forgevolt/Transmitter/README.md

# Transmitter

A general-purpose ESP32 remote control for small robots. It is not tied to any one machine: the
link carries a fixed set of controls, and the robot at the other end decides what they mean and
what the screen shows. A [hexapod](https://github.com/forgevolt/Hexapod) is the first thing it
was built to drive; adding another robot is a change to that robot's firmware, not to this one.

It comes in two variants, with one or two joysticks. Which one is running is a menu setting
stored on the device, and is announced to the robot when the link comes up.

| One joystick | Two joysticks |
|---|---|
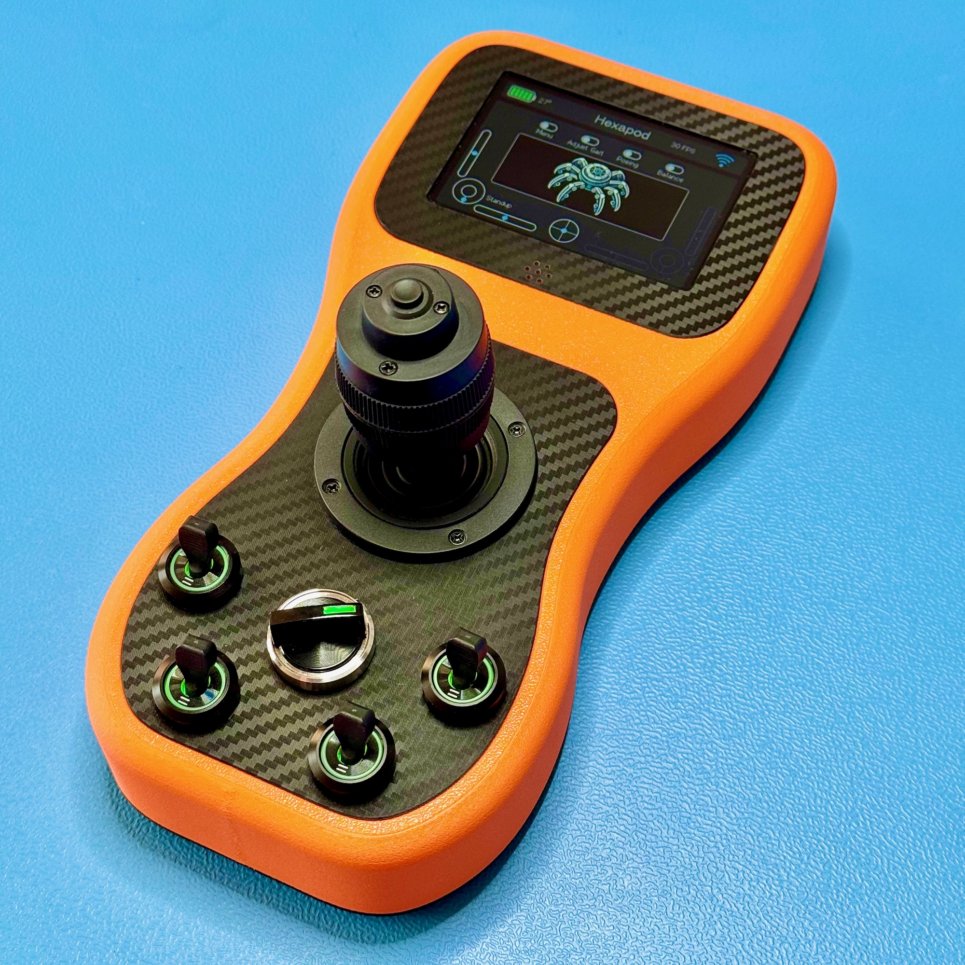
[picture p1: docs/transmitter-1joy.jpg]
Transmitter, one-joystick variant
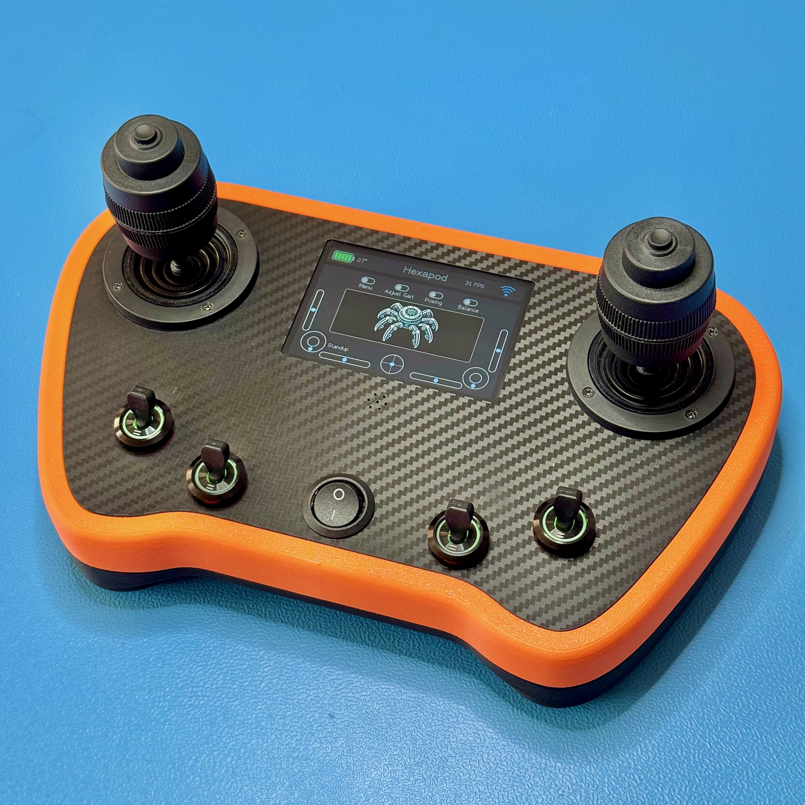
[picture p2: docs/transmitter-2joy.jpg]
Transmitter, two-joystick variant
|  |  |

## What it does

**Sends controls 20 times a second** — two 3-axis joysticks at ±1000 per axis, their two
buttons, four switches, and the transmitter's own tilt on two axes from the IMU. 

**Takes its screen contents from the robot.** The robot sends back a name, a device id (the 
transmitter presents an icon based on that information), a caption for each switch and button, 
and up to four label/value pairs. So a hexapod can label a switch `Gait` and display 
`height=` `13.4` without this firmware knowing anything about hexapods.

**Pairs by itself.** The robot broadcasts, the transmitter answers, and from then on each end
accepts frames only from the other. One peer at a time, dropped after a second of silence and
re-paired without user action. Both ends check a protocol version on every frame, so a robot
flashed from a different revision of the wire format reports a clear mismatch instead of
misreading values.

**Shows** battery charge, the paired robot's name and icon, live joystick positions, switch
states with their labels, IMU tilt, temperature, and an optional frame counter.

**Offers a menu** for joystick calibration (center and end stops per axis, stored in flash), IMU
calibration, one- or two-joystick selection, sound volume, frame-rate display, and a full reset.

**Makes noise** through an I2S amplifier — a click on every switch, a beep on button presses, a
sound at start-up.

## Hardware
- ESP32-WROOM-32E with 8 MB flash and no PSRAM (board package esp32 3.3.12)
- 480x320 TFT Display (ST7796 3.5)
- MPU6050 IMU  

## Repository layout

| | |
|---|---|
| [`software/`](software) | The Arduino sketch and its TFT_eSPI configuration |
| [`hardware/`](hardware) | PCB: EasyEDA project, Gerbers, schematic, bill of materials |
| [`mechanics/`](mechanics) | Housing: Fusion source, STLs, print profiles |
| [`docs/`](docs) | Photographs, wiring notes, display-image sources |

## The other end of the link

`software/Transmitter/RCProtocol.h` **is the master copy of the wire format.** It describes what
this transmitter can send and what it can display, so its shape follows this hardware rather
than any one robot's needs - which is why it lives here and not in the robot.

Every robot driven by this transmitter carries a copy of that file, because Arduino cannot
include across sketch folders. **Edit it here, then copy the result to each robot.**
`cAppProtocolVersion` is the guard: both ends check it on every frame, so a copy that has
fallen behind shows up as a logged mismatch at pairing rather than as silently misread data.

The robot announces itself with an `EDeviceType`, which is how the transmitter picks the icon
to show for it:

| Robot | `EDeviceType` |
|---|---|
| [Hexapod](https://github.com/forgevolt/Hexapod) | `eHexapod` |
| *(reserved for a balancing cube, not published)* | `eBalancingCube` |

A robot without its own image in `ReceiverStatus.cpp` is shown with a generic icon.

## Getting Started
1. Install the required libraries (see **Dependencies** below).
2. Open `software/Transmitter/Transmitter.ino` in the Arduino IDE.
3. Select the board and settings below.
4. Upload.

### Board settings

Board package **esp32 by Espressif, 3.3.12**. Select **ESP32 Dev Module** and change these
settings; everything else stays at its default:

| Setting | Value | Note |
| --- | --- | --- |
| Flash Size | **8MB (64Mb)** | the default is 4MB |
| PSRAM | **Disabled** | the module has none, and the firmware does not use any |
| Partition Scheme | **Custom** | only sets the upload size check; `partitions.csv` defines the layout, see below |

For `arduino-cli`, the same settings are the FQBN
`esp32:esp32:esp32:FlashSize=8M,PartitionScheme=custom`.

The partition scheme `software/Transmitter/partitions.csv` sits in the
sketch folder, and the ESP32 core uses it: a 6 MB application partition plus a 1.9 MB LittleFS 
partition. Nothing in the firmware writes to that filesystem today — calibration and settings 
live in NVS — so there is nothing to upload to it, but the space is reserved.

`partitions.csv` replaces whatever the Partition Scheme menu selects, so "Custom" is not strictly
needed. The menu only sets the size limit of the upload check: if "Custom" is not offered, choose
*Huge APP (3MB No OTA/1MB SPIFFS)*; the app is about 1.25 MB. With "Custom" the check allows the
whole 16 MB address space, so it does not guard the 6 MB application partition - a known limit,
far from the app's size.

The display needs no setting up: `software/Transmitter/build_opt.h` configures TFT_eSPI as part of
the build. See [software/Config/TFT_eSPI](software/Config/TFT_eSPI/README.md) if you would rather
configure the library the conventional way, or if you are not using the ESP32 Arduino core.

## Dependencies

Versions are the ones this project is built and tested against.

**Bundled with the ESP32 board package** - nothing to install: `WiFi`, `Networking`, `Wire`,
`SPI`, `Preferences`, and the ESP-IDF `driver/i2s_std.h` audio API that SoundEngine sits on.

**From the Arduino Library Manager** - all of them, including the four written for this project:

| Library | Version | Note |
|---|---|---|
| Streaming | 6.3.0 | |
| TFT_eSPI | 2.5.43 | by Bodmer - configured by `build_opt.h`, see above |
| Bounce2 | 2.71 | |
| MPU6050_light | 1.2.1 | by rfetick - several MPU6050 libraries exist, this is the one used here |
| Adafruit MAX1704X | 1.0.3 | |
| Adafruit BusIO | 1.17.4 | dependency of MAX1704X |
| [ESPNowUtilities](https://github.com/forgevolt/ESPNowUtilities) | 1.0.1 | the ESP-NOW transport `RCProtocol.h` is built on |
| [JoystickUtilities](https://github.com/forgevolt/JoystickUtilities) | 1.0.0 | reading, calibrating and storing the joysticks |
| [SoundEngine](https://github.com/forgevolt/SoundEngine) | 1.1.1 | `SoundEngine.h` and the `sounds/` clips |
| [VectorUtilities](https://github.com/forgevolt/VectorUtilities) | 1.0.0 | `mapf()`, `deg2rad` and the disk mapping of the IMU display |

## Compiler warnings

`software/Transmitter/build_opt.h` switches on more warnings than the core does:

```
-Wall
-Wextra
-Wdouble-promotion
-Wsign-compare
```

`-Wdouble-promotion` matters on the ESP32, which has no hardware double: it catches float maths
that silently turns into slow double maths. `-Wsign-compare` has to be listed by name: the core's
`cpp_flags` passes `-Wno-sign-compare`, and a specific `-Wno-` beats a later umbrella flag such as
`-Wall`. Arduino expands `build_opt.h` after `cpp_flags`, which is why overriding it there works.
The same file carries the TFT_eSPI configuration as `-D` flags; it is a compiler response file,
so it may hold flags only, no comments.

The firmware builds without a warning from its own sources. The flags apply to the core and the
libraries as well, so a clean build still lists about 70 warnings from those (core 3.3.12, the
MPU6050_light, TFT_eSPI and Adafruit MAX1704X libraries).

The IDE setting *Compiler warnings: None* (File → Preferences) passes `-w`, which hides every
warning, including the ones `build_opt.h` asks for. Use *Default* or higher. The IDE's output
panel also drops the start of a long log, so for a full warning check compile with the
`arduino-cli` that ships with the IDE and keep the log in a file outside the repository
(macOS paths):

```bash
CLI="/Applications/Arduino IDE.app/Contents/Resources/app/lib/backend/resources/arduino-cli"
cd software
"$CLI" compile --clean --warnings all \
  --fqbn "esp32:esp32:esp32:FlashSize=8M,PartitionScheme=custom" \
  Transmitter 2>&1 | tee ~/transmitter-build.log
```

`--warnings all` matters: without it `arduino-cli` uses `none`, which passes `-w` just like the
IDE setting. The flags themselves come from `build_opt.h`.

## How it runs

Four FreeRTOS tasks matter here. Everything the operator sees and sends runs in `loop()`:

| Task | Priority | Core | Rate | Does |
| --- | --- | --- | --- | --- |
| `loopTask` | 1 | 1 | screen 30 fps, send 20 Hz | `loop()`: input snapshot, UI step and draw, and the control frames - each job on its own schedule |
| `processEvents` | 1 | 1 | every 2 ms | debounces the two joystick buttons and the four switches (`InputController`) |
| `fillBuffer` | 1 | 1 | - | mixes and queues the next audio chunk (owned by SoundEngine) |
| Wi-Fi task | 23 | 0 | - | the ESP-NOW receive callback: pairing requests and the robot's telemetry |

The joysticks are read from `loop()` only. The button and switch state is shared with
`processEvents` under a mutex, and the received telemetry with the Wi-Fi task under another.

## License
This project is licensed under the MIT License – see the [LICENSE](LICENSE) file for details.
