forgevolt/Transmitter/docs/images/Hexapod.png

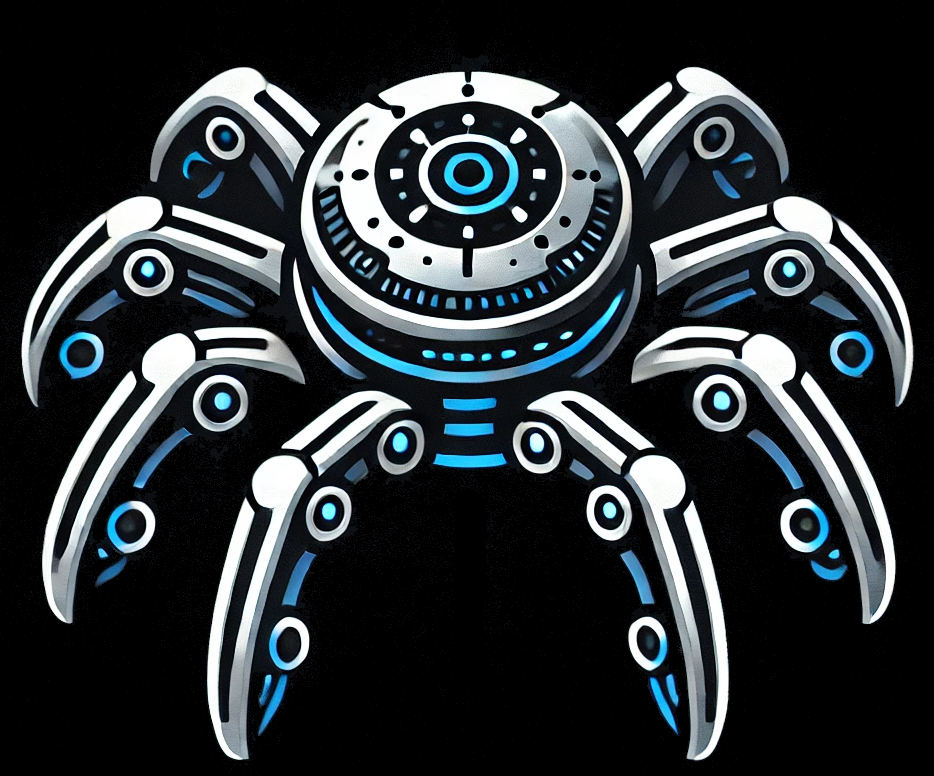
docs/images/Hexapod.png
