forgevolt/Transmitter/docs/images/UnknowReceiver.png

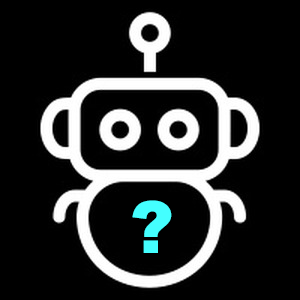
docs/images/UnknowReceiver.png
