forgevolt/Transmitter/hardware/bom.csv

No. | Quantity | Comment | Designator | Footprint | Value | Manufacturer Part | Manufacturer | Supplier Part | Supplier
1 | 1 | KLJ-01504T-08R05W | BUZ500 | BUZ-SMD_4P-L15.0-W15.0-BL |  | KLJ-01504T-08R05W | KELIKING(凯丽金) | C18186316 | LCSC
2 | 9 | 100nF | C200,C201,C204,C301,C302,C405,C501,C601,C602 | C0402_IPC | 100nF | CL05B104KO5NNNC | SAMSUNG(三星) | C1525 | LCSC
3 | 4 | 4.7uF | C202,C203,C406,C407 | C0805 | 4.7uF | GRM21BR71A475KE51L | muRata(村田) | C415536 | LCSC
4 | 1 | 22uF | C300 | C0805 | 22uF | CL21A226MAQNNNE | SAMSUNG(三星) | C45783 | LCSC
5 | 2 | 1uF | C303,C400 | C0603 | 1uF | CL10B105KP8NNNC | SAMSUNG(三星) | C95843 | LCSC
6 | 5 | 10uF | C401,C402,C403,C404,C500 | C0805 | 10uF | GCM21BR71A106KE22L | muRata(村田) | C126586 | LCSC
7 | 2 | 220pF | C502,C503 | C0402_IPC | 220pF | 0402B221K500NT | FH(风华) | C1530 | LCSC
8 | 1 | 10nF | C600 | C0402_IPC | 10nF | GRM155R71E103KA01D | muRata(村田) | C77013 | LCSC
9 | 1 | 2.2nF | C603 | C0402_IPC | 2.2nF | 0402B222K500NT | FH(风华) | C1531 | LCSC
10 | 1 | USBLC6-2SC6 | D200 | SOT-23-6_L2.9-W1.6-P0.95-LS2.8-BL |  | USBLC6-2SC6 | ST(意法半导体) | C7519 | LCSC
11 | 1 | Display | H700 | HDR-TH_9P-P2.54-V-F-1 |  | 2.54-1*9P母 | BOOMELE(博穆精密) | C39576 | LCSC
12 | 1 | SOLDERJUMPER | J300 | SOLDERJUMPER
13 | 2 | GZ1608D121TF SMT业务专用 | L500,L501 | L0603 |  | GZ1608D121TF SMT业务专用 |  | C18527 | LCSC
14 | 1 | +3V3 | LED400 | LED0402-RD_YELLOW
15 | 1 | Charge | LED401 | LED0805-RD_GREEN
16 | 4 | M3-MOUNT-HOLE | M700,M701,M702,M703 | M3-MOUNT-HOLE
17 | 1 | SMUN5211DW1T1G | Q300 | SOT-363_L2.0-W1.3-P0.65-LS2.1-BL |  | SMUN5211DW1T1G | onsemi(安森美) | C463894 | LCSC
18 | 1 | 22.1kΩ | R200 | R0402 | 22.1kΩ | 0402WGF2212TCE | UNI-ROYAL(厚声) | C43473 | LCSC
19 | 1 | 47.5kΩ | R201 | R0402 | 47.5kΩ | 0402WGF4752TCE | UNI-ROYAL(厚声) | C25896 | LCSC
20 | 1 | 1kΩ | R202 | R0402 | 1kΩ | 0402WGF1001TCE | UNI-ROYAL(厚声) | C11702 | LCSC
21 | 2 | 5.1kΩ | R203,R204 | R0402 | 5.1kΩ | 0402WGF5101TCE | UNI-ROYAL(厚声) | C25905 | LCSC
22 | 4 | 4.7kΩ | R300,R301,R403,R600 | R0402 | 4.7kΩ | 0402WGJ0472TCE | UNI-ROYAL(厚声) | C25940 | LCSC
23 | 4 | 10kΩ | R302,R400,R401,R404 | R0402 | 10kΩ | 0402WGF1002TCE | UNI-ROYAL(厚声) | C25744 | LCSC
24 | 1 | 2kΩ | R402 | R0402 | 2kΩ | 0402WGF2001TCE | UNI-ROYAL(厚声) | C4109 | LCSC
25 | 1 | 0Ω_DNP | R500 | R0402 | 0Ω | 0402WGJ0000TCE | UNI-ROYAL(厚声) | C21376 | LCSC
26 | 1 | 0Ω | R501 | R0402 | 0Ω | 0402WGJ0000TCE | UNI-ROYAL(厚声) | C21376 | LCSC
27 | 1 | 1MΩ | R502 | R0402 | 1MΩ | 0402WGF1004TCE | UNI-ROYAL(厚声) | C26083 | LCSC
28 | 1 | Reset | SW300 | SW-SMD_5P-L4.2-W2.8-P1.60-LS4.6-TR |  | KMR211GLFS | C&K | C221675 | LCSC
29 | 1 | USB | TP200 | TESTPOINT-SMD |  | KH-PG2012005-DZ | kinghelm(金航标) | C2842936 | LCSC
30 | 1 | VIN | TP400 | TESTPOINT-SMD |  | KH-PG2012005-DZ | kinghelm(金航标) | C2842936 | LCSC
31 | 1 | +3V3 | TP401 | TESTPOINT-SMD |  | KH-PG2012005-DZ | kinghelm(金航标) | C2842936 | LCSC
32 | 1 | VBAT | TP402 | TESTPOINT-SMD |  | KH-PG2012005-DZ | kinghelm(金航标) | C2842936 | LCSC
33 | 1 | CP2102N-A02-GQFN24R | U200 | QFN-24_L4.0-W4.0-P0.50-TL-EP2.6 |  | CP2102N-A02-GQFN24R | SKYWORKS/SILICON LABS(芯科) | C969151 | LCSC
34 | 1 | ESP32-WROOM-32E-N8 | U300 | WIFI-SMD_ESP32-WROOM-32E |  | ESP32-WROOM-32E-N8 | ESPRESSIF(乐鑫) | C701342 | LCSC
35 | 1 | AP3602AKTR-G1 | U400 | SOT-23-6_L2.9-W1.6-P0.95-LS2.8-BR |  | AP3602AKTR-G1 | DIODES(美台) | C460358 | LCSC
36 | 1 | LM66200DRLR | U401 | SOT-583-8_L2.1-W1.2-P0.50-LS1.6-BL |  | LM66200DRLR | TI(德州仪器) | C3235556 | LCSC
37 | 1 | LD39200PUR | U402 | DFN-6_L3.0-W3.0-P0.95-BL-EP-1 |  | LD39200PUR | ST(意法半导体) | C2969757 | LCSC
38 | 1 | MCP73831T-2ACI/MC | U403 | DFN-8_L3.0-W2.0-P0.50-BL-EP1.6 |  | MCP73831T-2ACI/MC | MICROCHIP(美国微芯) | C411870 | LCSC
39 | 1 | MAX17048G+T10 | U404 | DFN-8_L2.0-W2.0-P0.50-BL-EP |  | MAX17048G+T10 | ADI(亚德诺)/MAXIM(美信) | C2682616 | LCSC
40 | 1 | MAX98357AETE+T | U500 | TQFN-16_L3.0-W3.0-P0.50-BL-EP1.5 |  | MAX98357AETE+T | ADI(亚德诺)/MAXIM(美信) | C910544 | LCSC
41 | 1 | MPU-6050 | U600 | QFN-24_L4.0-W4.0-P0.50-BL-EP2.7 |  | MPU-6050 | TDK InvenSense(应美盛) | C24112 | LCSC
42 | 1 | Lipo | U700 | conn-th_2p-p2.00_bx-ph2.0-2pwz |  | BX-PH2.0-2PWZ | Bossie(博锡) | C18077753 | LCSC
43 | 1 | Joystick Left | U701 | CONN-TH_6P-P2.00_BX-PH2.0-6PWZ |  | BX-PH2.0-6PWZ | Bossie(博锡) | C18077757 | LCSC
44 | 1 | Joystick Right | U702 | conn-th_6p-p2.00_bx-ph2.0-6pwz |  | BX-PH2.0-6PWZ | Bossie(博锡) | C18077757 | LCSC
45 | 1 | On/Off | U703 | CONN-TH_4P-P2.00_BX-PH2.0-4PWZ |  | BX-PH2.0-4PWZ | Bossie(博锡) | C18077755 | LCSC
46 | 1 | Switch 1 | U704 | CONN-TH_3P-P2.00_BX-PH2.0-3PWZ |  | BX-PH2.0-3PWZ | Bossie(博锡) | C18077754 | LCSC
47 | 1 | Switch 3 | U705 | CONN-TH_3P-P2.00_BX-PH2.0-3PWZ |  | BX-PH2.0-3PWZ | Bossie(博锡) | C18077754 | LCSC
48 | 1 | Switch 2 | U706 | CONN-TH_3P-P2.00_BX-PH2.0-3PWZ |  | BX-PH2.0-3PWZ | Bossie(博锡) | C18077754 | LCSC
49 | 1 | Switch 4 | U707 | CONN-TH_3P-P2.00_BX-PH2.0-3PWZ |  | BX-PH2.0-3PWZ | Bossie(博锡) | C18077754 | LCSC
50 | 1 | USB4105-GF-A | USB200 | TYPE-C-SMD_SBC-160S1A-20-S412 |  | USB4105-GF-A | GCT | C3020560 | LCSC
