forgevolt/Transmitter/mechanics/print-profiles/2-Joystick-LightPipe.3mf

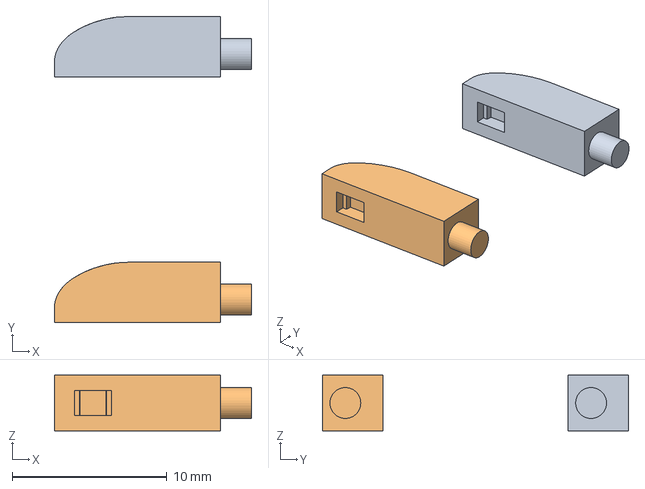
[picture p5: CAD file, 2026-08-06]
mechanics/print-profiles/2-Joystick-LightPipe.3mf
12.8 x 19.8 x 3.60 mm
Spot-2-Joysticks.stl x 2
