forgevolt/Transmitter/mechanics/stl/2-joysticks.stl

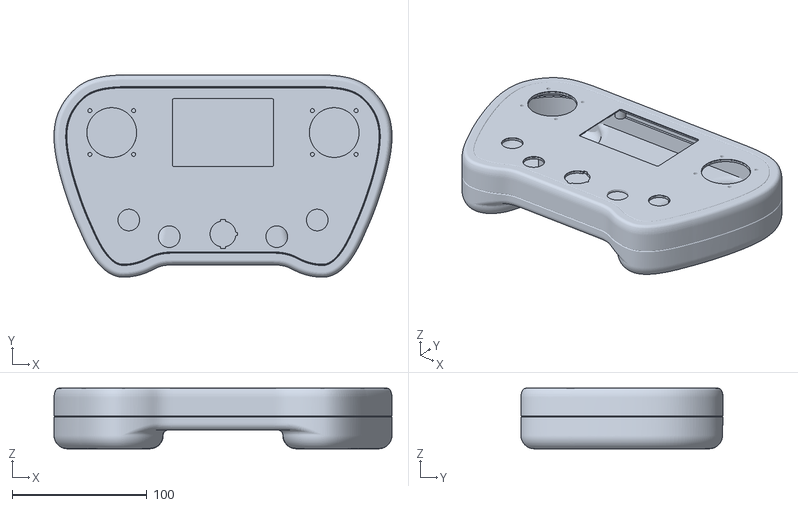
[picture p6: CAD file, 2026-08-06]
mechanics/stl/2-joysticks.stl
251.1 x 150.3 x 45.0
