forgevolt/Transmitter/mechanics/print-profiles/2-Joystick-Bottom-h2d-PETG-CF.3mf

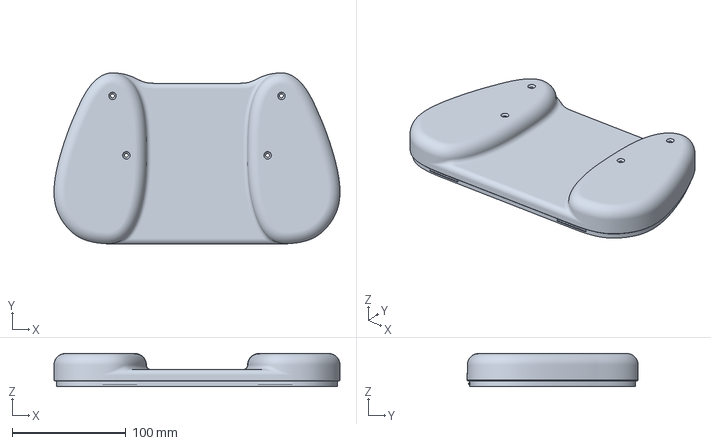
[picture p7: CAD file, 2026-08-06]
mechanics/print-profiles/2-Joystick-Bottom-h2d-PETG-CF.3mf
251.1 x 150.3 x 29.0 mm
