forgevolt/Transmitter/mechanics/stl/1-joystick.stl

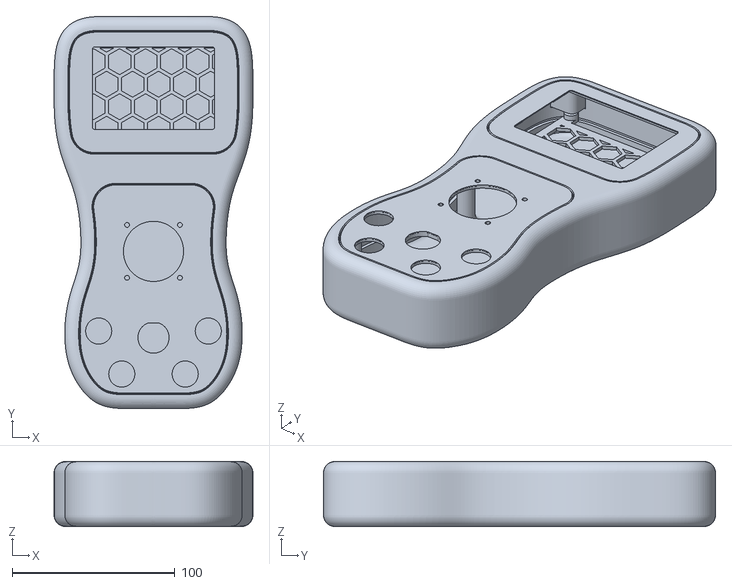
[picture p8: CAD file, 2026-08-06]
mechanics/stl/1-joystick.stl
122.3 x 241.1 x 40.0
