forgevolt/Transmitter/mechanics/print-profiles/1-Joystick-Top-h2d-ABS-GF.3mf

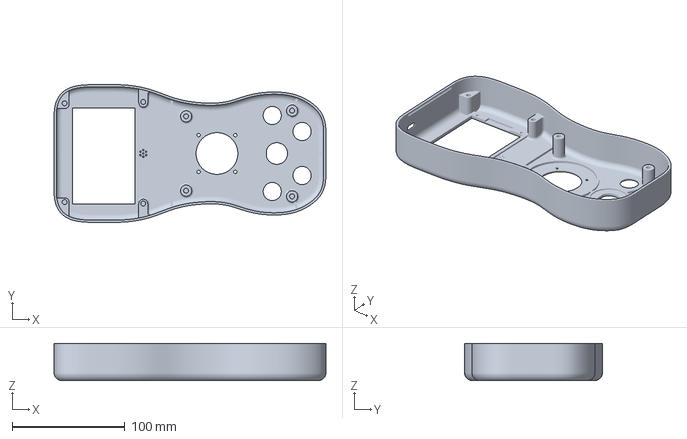
[picture p9: CAD file, 2026-08-06]
mechanics/print-profiles/1-Joystick-Top-h2d-ABS-GF.3mf
241.1 x 122.3 x 33.0 mm
