forgevolt/Transmitter/mechanics/print-profiles/2-Joystick-Top-h2d-ABS-GF.3mf

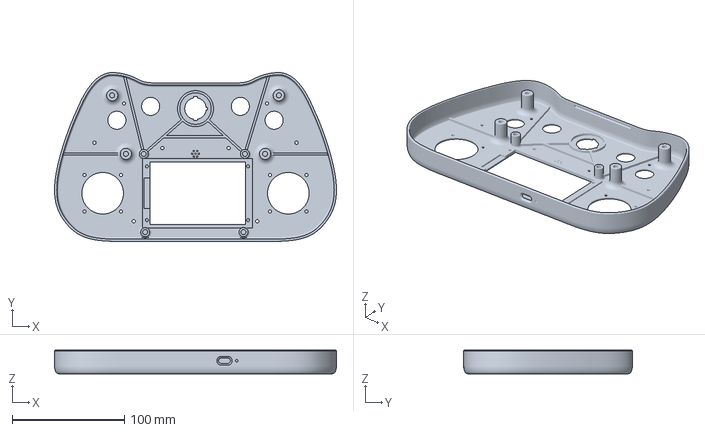
[picture p10: CAD file, 2026-08-06]
mechanics/print-profiles/2-Joystick-Top-h2d-ABS-GF.3mf
251.1 x 150.3 x 21.0 mm
