forgevolt/Transmitter/mechanics/print-profiles/1-Joystick-Bottom-h2d-PLA-GF.3mf

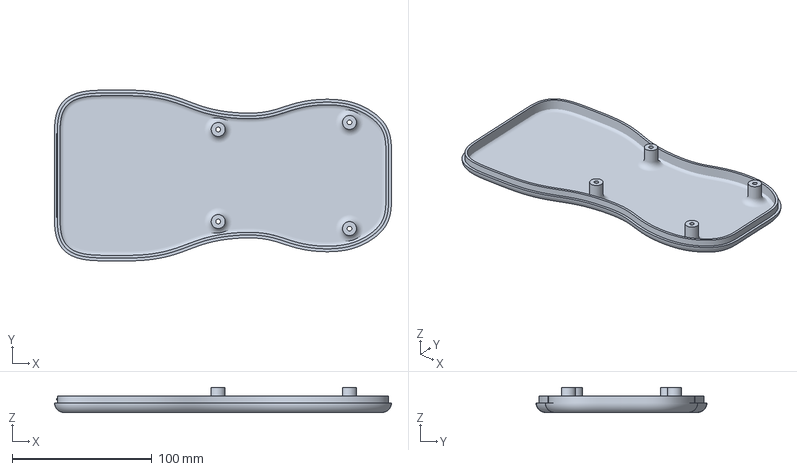
[picture p11: CAD file, 2026-08-06]
mechanics/print-profiles/1-Joystick-Bottom-h2d-PLA-GF.3mf
241.1 x 122.3 x 18.0 mm
