forgevolt/Transmitter/mechanics/print-profiles/1-Joystick-LightPipe.3mf

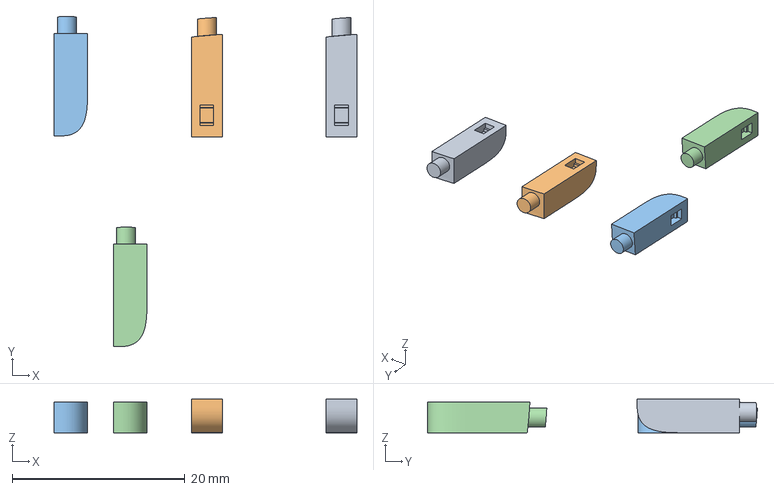
[picture p12: CAD file, 2026-08-06]
mechanics/print-profiles/1-Joystick-LightPipe.3mf
35.1 x 38.2 x 3.90 mm
1-Joystick.stl x 4
