forgevolt/Transmitter/mechanics/print-profiles/2-Joystick-CarbonPlatePrinting.3mf

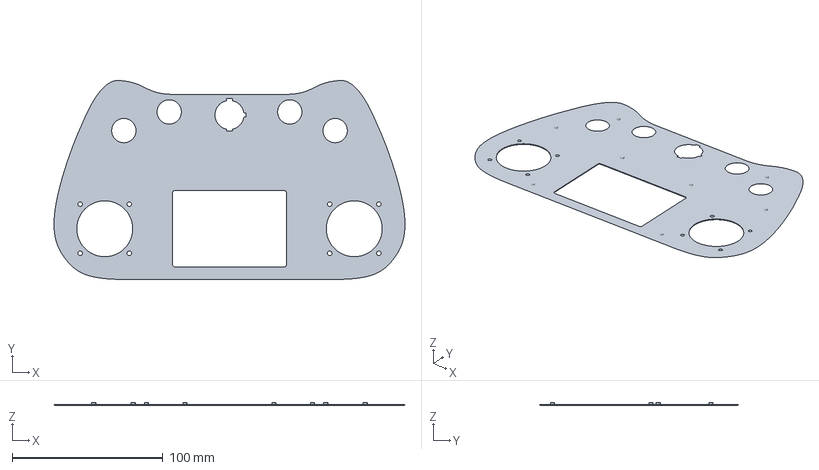
[picture p13: CAD file, 2026-08-06]
mechanics/print-profiles/2-Joystick-CarbonPlatePrinting.3mf
232.5 x 131.7 x 1.90 mm
