forgevolt/Transmitter/(list of files, cad)

Other CAD files:
mechanics/print-profiles/2-Joystick-Bottom-h2d-ABS-GF.3mf
mechanics/print-profiles/2-Joystick-Bottom-h2d-PLA-CF.3mf
mechanics/cad/Remote.f3z
