forgevolt/Transmitter/hardware/schematic.pdf

Drawn
VER

Create Date

PAGE | OF

Schematic

Update Date

SIZE

Page

2025-01-01

## 2025-01-01 Remote_R2

## Overview

# Hobbyist

## Christoph Streit

1 | A4

# Microcontroller

# Audio & IMU

Sheet: USB&Serial | Sheet: ESP32
2 | 3

# Sheet: Audio

5

I/O

# Sheet: Connectors / IO

7

# Power

# Sheet: Power

4

6

# Sheet: IMU

# USB to Serial USB

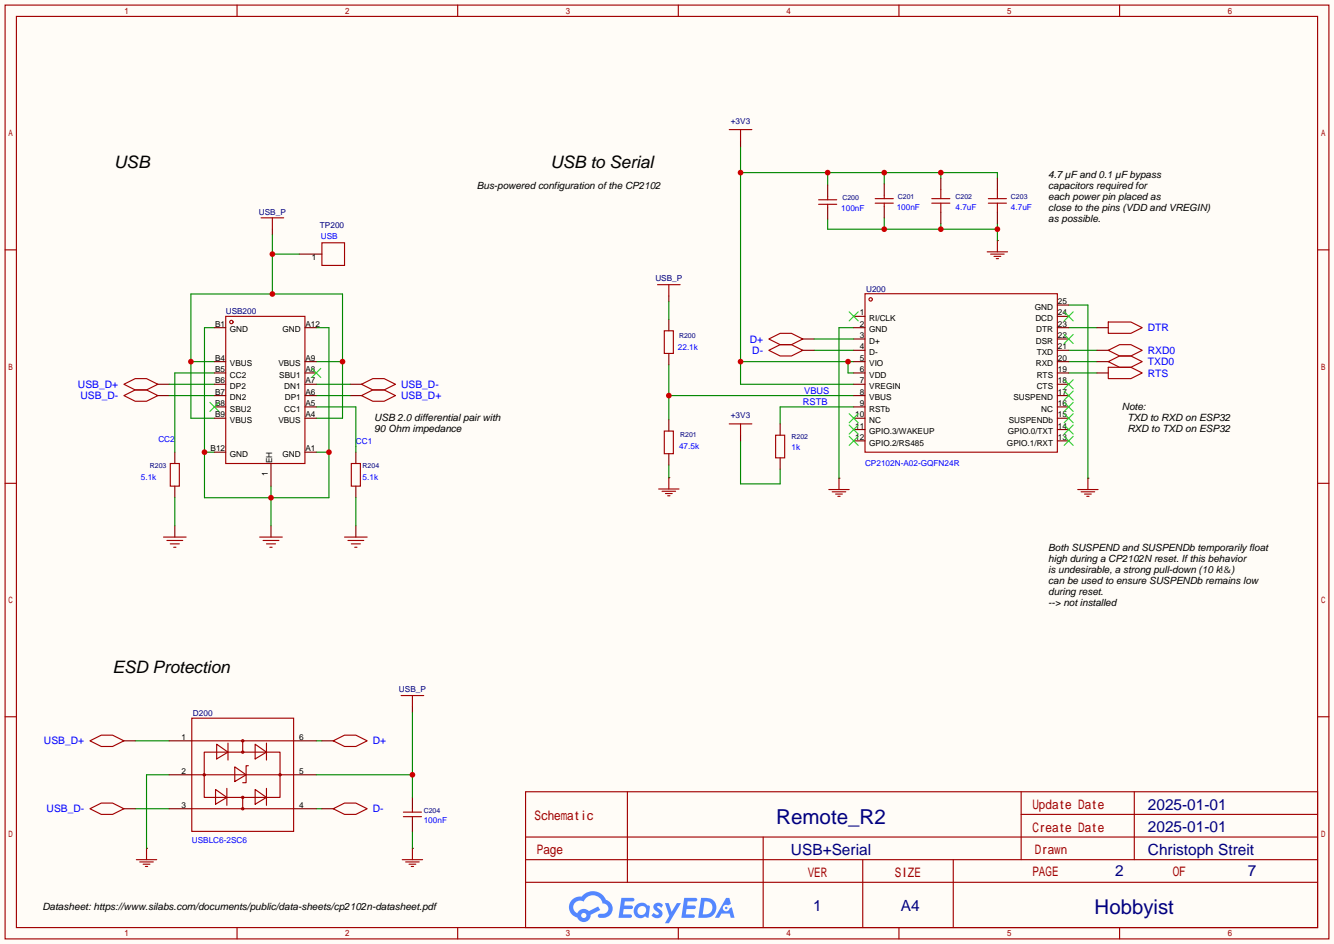
[picture p14: page 2]

4.7 µF and 0.1 µF bypass
capacitors required for
each power pin placed as
close to the pins (VDD and VREGIN)
as possible.

Bus-powered configuration of the CP2102

Note:
TXD to RXD on ESP32
RXD to TXD on ESP32

Both SUSPEND and SUSPENDb temporarily float
high during a CP2102N reset. If this behavior
is undesirable, a strong pull-down (10 k!&)
can be used to ensure SUSPENDb remains low
during reset.
--> not installed

Datasheet: https://www.silabs.com/documents/public/data-sheets/cp2102n-datasheet.pdf

# ESP32--WROOM-32E

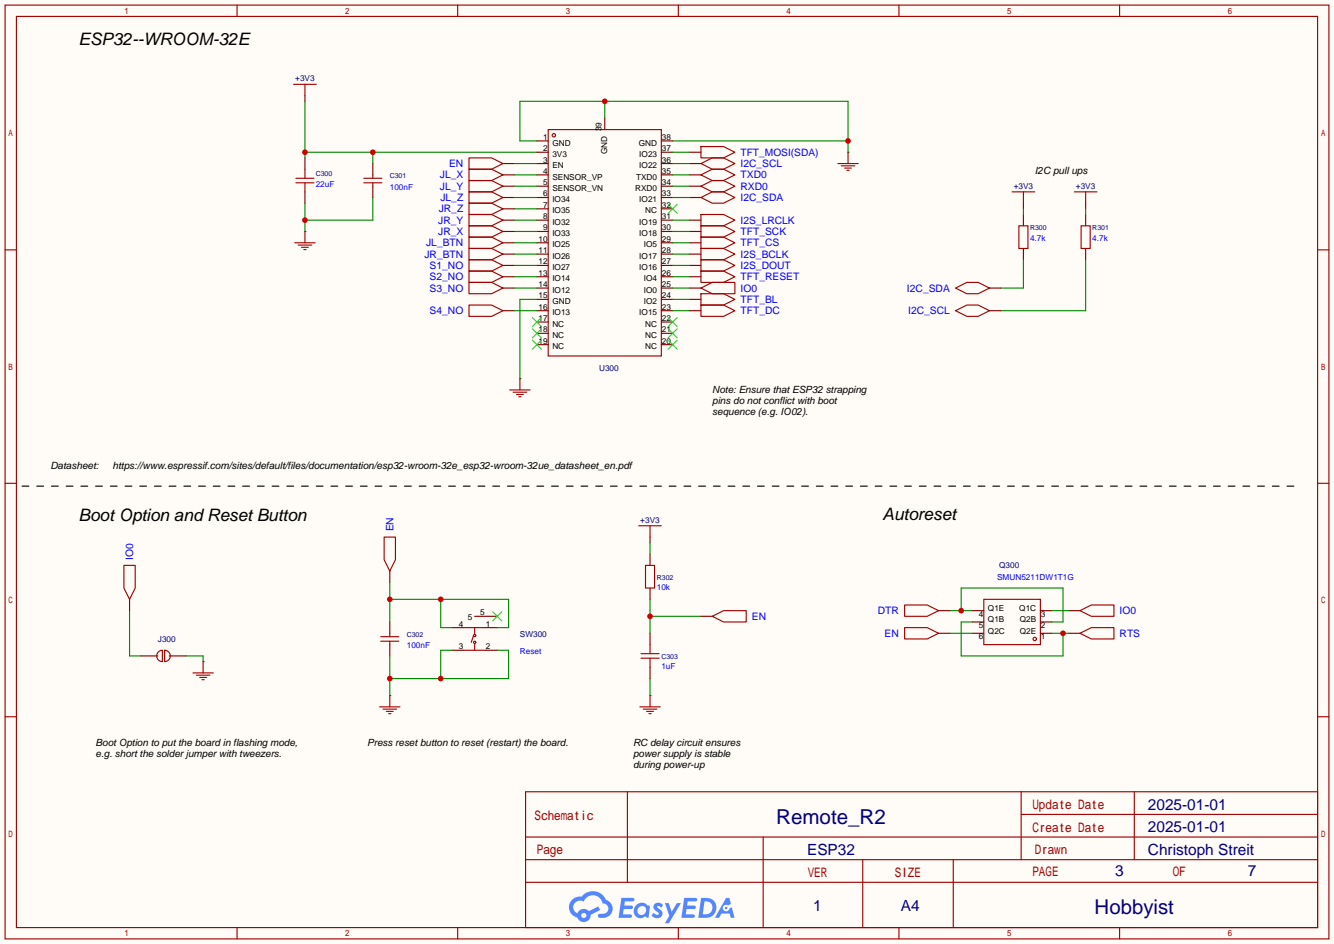
[picture p15: page 3]

Note: Ensure that ESP32 strapping
pins do not conflict with boot
sequence (e.g. IO02).

https://www.espressif.com/sites/default/files/documentation/esp32-wroom-32e_esp32-wroom-32ue_datasheet_en.pdf

Boot Option to put the board in flashing mode,
e.g. short the solder jumper with tweezers.

Press reset button to reset (restart) the board.

RC delay circuit ensures
power supply is stable
during power-up

# Automatic Switchover Charge Pump (+5V)

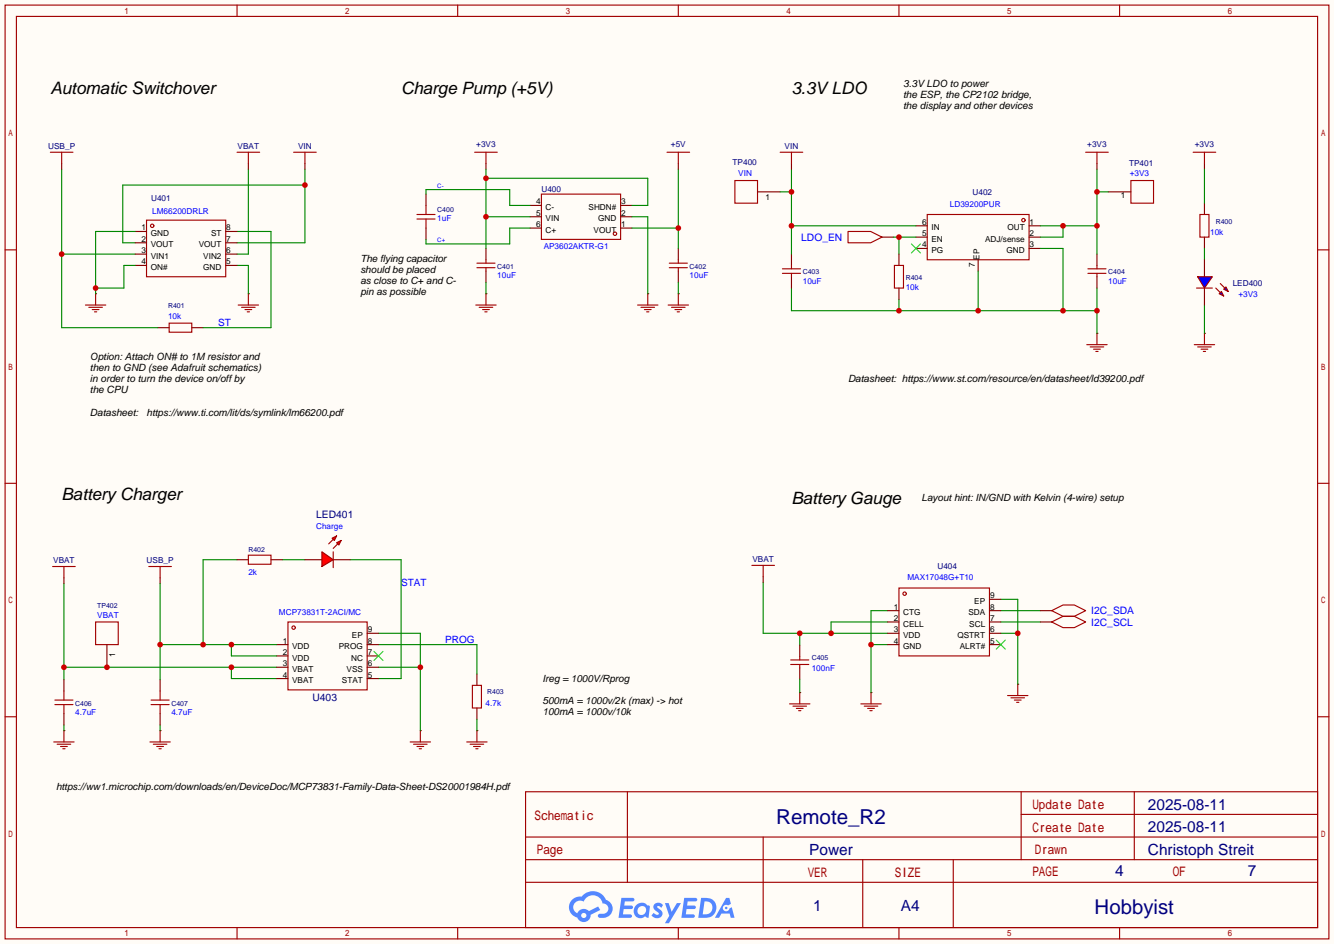
[picture p16: page 4]

the ESP, the CP2102 bridge,
the display and other devices

The flying capacitor
should be placed
as close to C+ and C-
pin as possible

Option: Attach ON# to 1M resistor and
then to GND (see Adafruit schematics)
in order to turn the device on/off by
the CPU
Datasheet: https://www.ti.com/lit/ds/symlink/lm66200.pdf

Datasheet: https://www.st.com/resource/en/datasheet/ld39200.pdf

Layout hint: IN/GND with Kelvin (4-wire) setup

https://ww1.microchip.com/downloads/en/DeviceDoc/MCP73831-Family-Data-Sheet-DS20001984H.pdf

## Gain Selection

## Amplifier

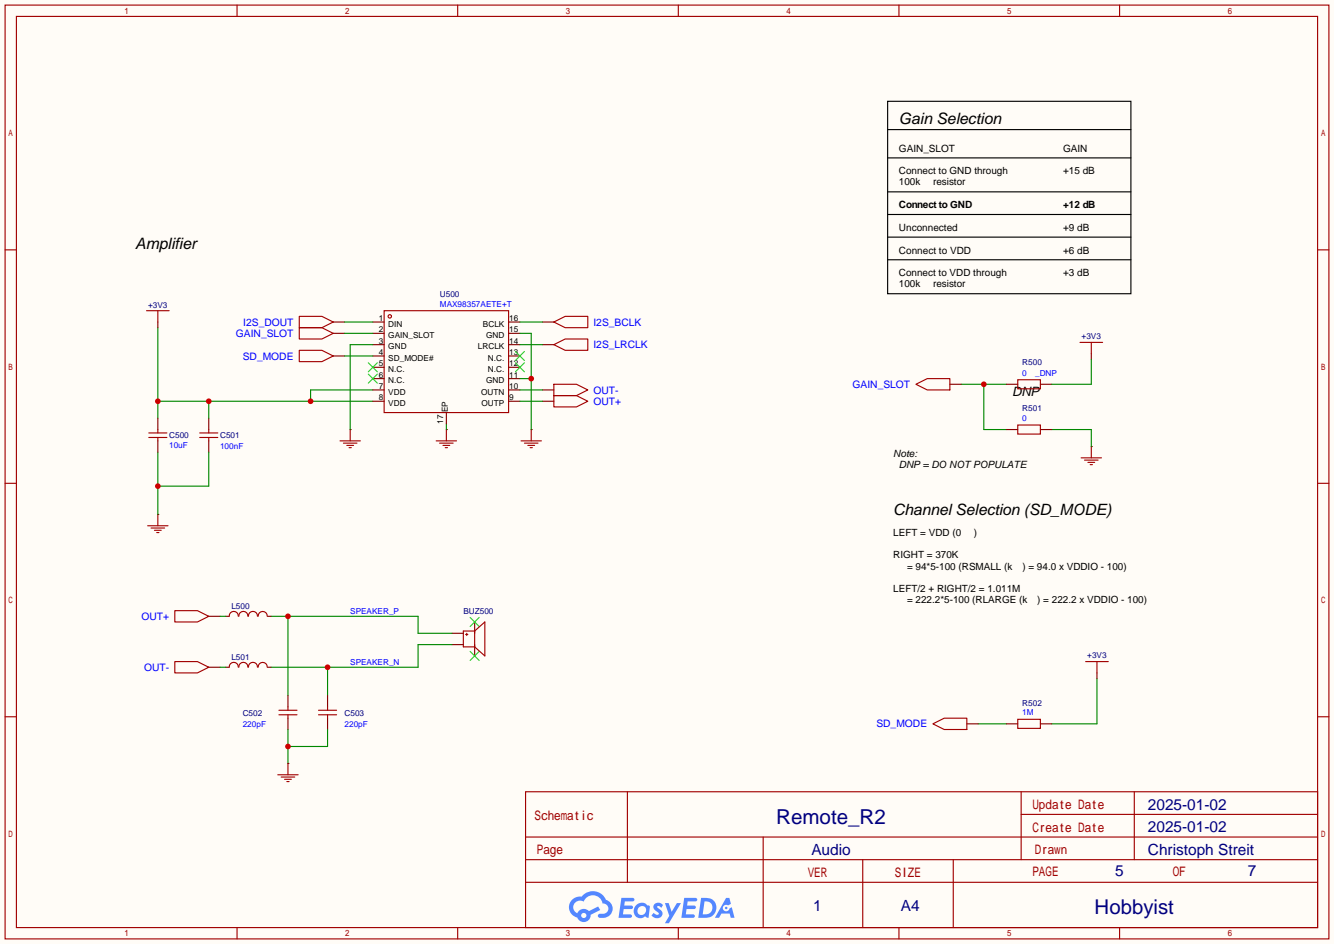
[picture p17: page 5]

Connect to GND through
100k resistor
Connect to GND
Unconnected
Connect to VDD
Connect to VDD through

Note:
DNP = DO NOT POPULATE

## IMU

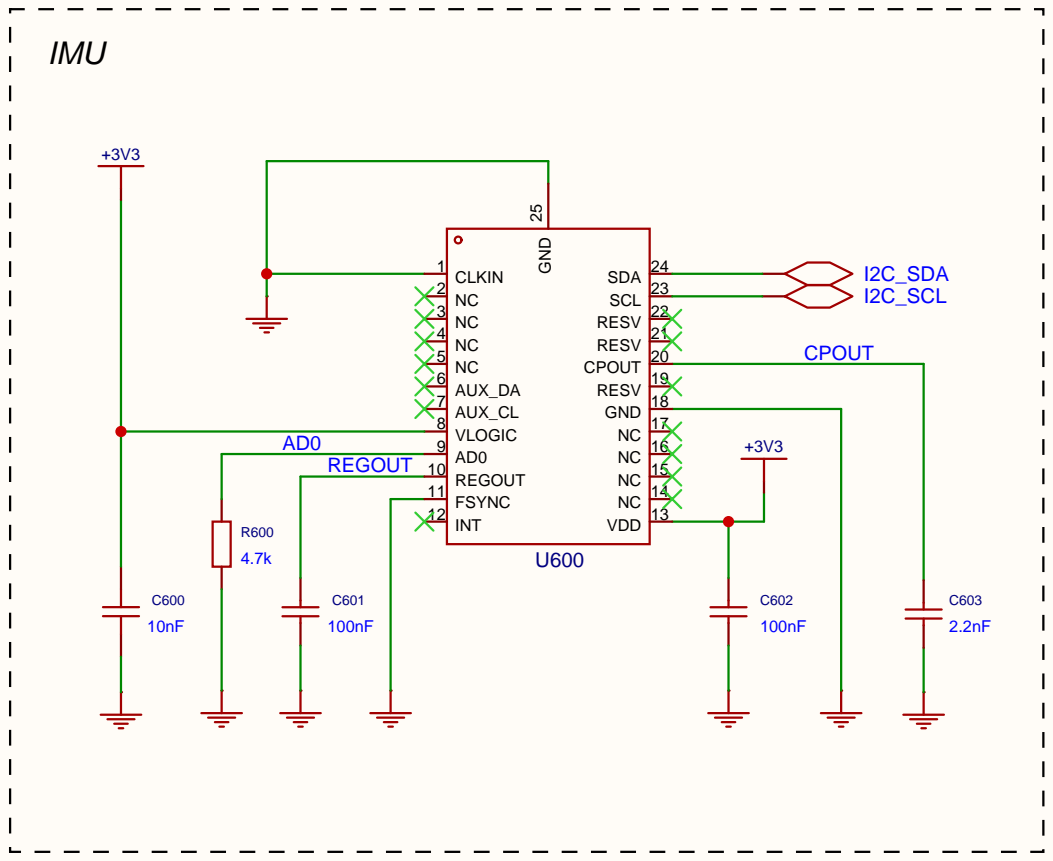
[picture p18: page 6]

Display | On/Off

# M2 Mounting Holes

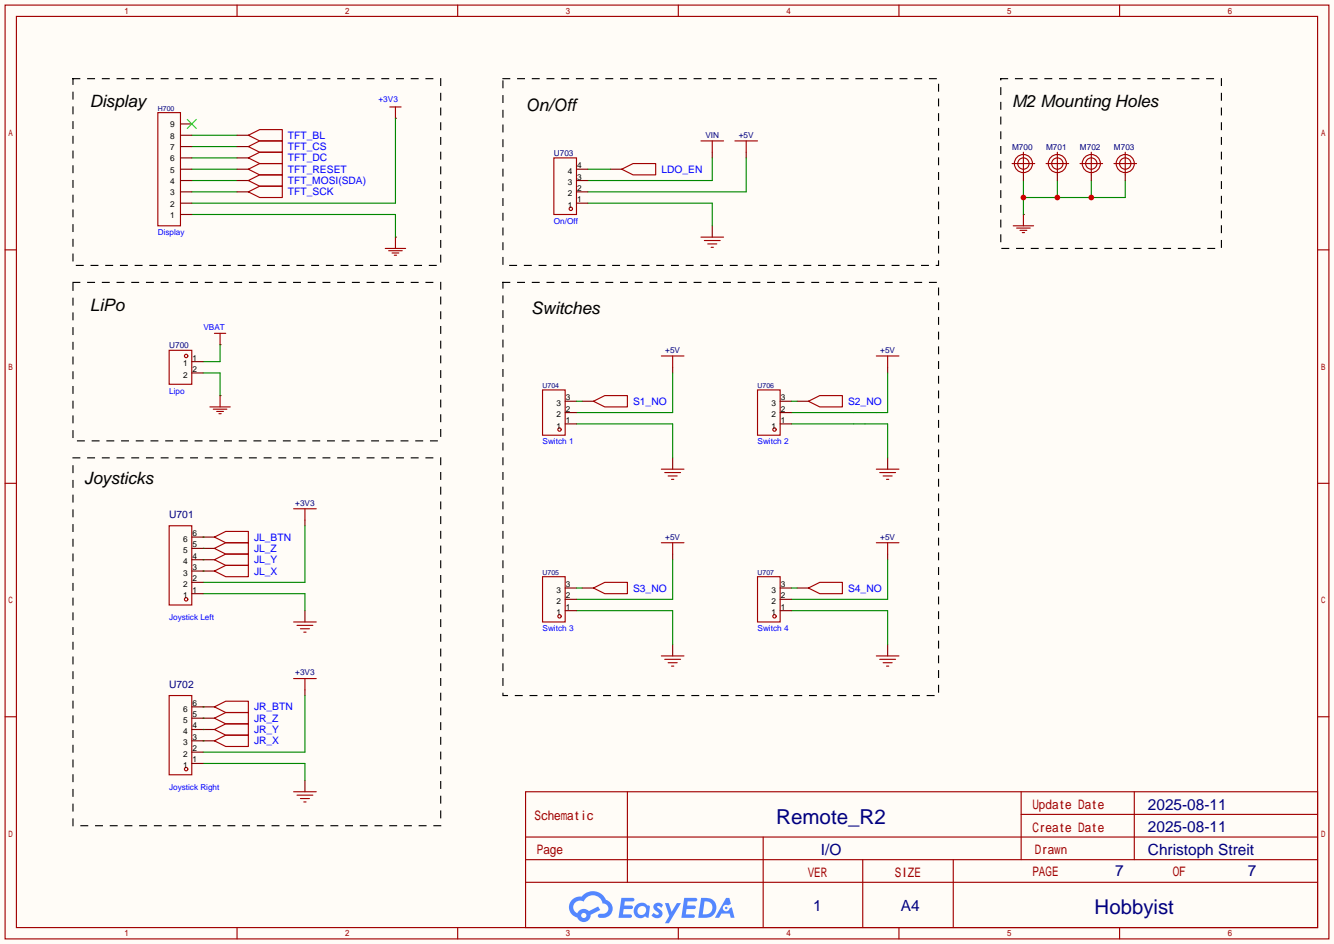
[picture p19: page 7]
