forgevolt/Transmitter/software/Transmitter/BatteryStatus.cpp

#include <TFT_eSPI.h>
#include "BatteryStatus.h"

// ---- BatteryStatus ---------------------------------------------------------------------

namespace
{

constexpr uint32_t c80_100 = cGreenCol;
constexpr uint32_t c60_80  = 0x9EC9;
constexpr uint32_t c40_60  = 0xFEA0;
constexpr uint32_t c20_40  = 0xEB86;
constexpr uint32_t c00_20  = 0xC000;

constexpr float cPosX = 20;
constexpr float cPosY = 17;

constexpr unsigned long cPollIntervalMs  = 30000; // the fuel gauge is read this often, not per frame
constexpr unsigned long cRetryIntervalMs = 5000;  // while there is no valid reading

// Low battery: below cLowPercent the icon blinks and the signal tone plays, repeated every
// cWarnRepeatMs. The hysteresis stops a charge hovering at the threshold from toggling.
constexpr float         cLowPercent    = 10.0f;
constexpr float         cLowHysteresis = 2.0f;
constexpr unsigned long cWarnRepeatMs  = 60000;
constexpr unsigned long cBlinkMs       = 500;

} // namespace

// ----------------------------------------------------------------------------------------
BatteryStatus::BatteryStatus(UserInterface& ui, Adafruit_MAX17048& batteryMonitor)
: DisplayObject(ui),
  myFuelGauge(batteryMonitor),
  myLastUpdate(millis() - cPollIntervalMs), // so the first step() reads at once (unsigned, wrap-safe)
  myCellPercent(-1)
{}

// ----------------------------------------------------------------------------------------
void BatteryStatus::step(unsigned long dt)
{
  if (isActive() == false)
    return;

  // ---- Read the gauge
  // cellPercent() returns NAN when the gauge does not answer. A failed read clears the value:
  // only the outline is drawn, and the gauge is retried every cRetryIntervalMs until it answers
  // again. NAN itself must not reach draw() - it fails every comparison and would show as an
  // empty battery.
  const unsigned long interval = (myCellPercent < 0) ? cRetryIntervalMs : cPollIntervalMs;
  if (millis() - myLastUpdate > interval)
  {
    myLastUpdate = millis();

    const float percent = myFuelGauge.cellPercent();
    myCellPercent = (isnan(percent) == true) ? -1.0f : percent;
    markRedraw();
  }

  // ---- Low battery
  if (myCellPercent >= 0 && myCellPercent < cLowPercent)
  {
    myIsLow = true;
  }
  else if (myCellPercent < 0 || myCellPercent > cLowPercent + cLowHysteresis)
  {
    // Charged again, or no reading: no warning.
    myIsLow = false;
    myLowWarnedAt = 0; // a later drop warns at once
  }

  const unsigned long now = millis();
  const bool blinkOn = (myIsLow == false) || ((now / cBlinkMs) % 2 == 0);
  if (blinkOn != myBlinkOn)
  {
    myBlinkOn = blinkOn;
    markRedraw();
  }

  if (myIsLow == true && (myLowWarnedAt == 0 || now - myLowWarnedAt >= cWarnRepeatMs))
  {
    myLowWarnedAt = now;
    myUI.signal();
  }
}

// ----------------------------------------------------------------------------------------
void BatteryStatus::draw(bool forceRedraw)
{
  if (isActive() == false || (forceRedraw == false && needsRedraw() == false))
    return;

  clearRedrawFlags();

  // Clear before redrawing
  myUI.tft().fillRect(cPosX-1, cStatusAreaPosY, 53, cStatusAreaHeight, cStatusAreaCol);

  uint32_t col;
  int numSeg;

  if (myCellPercent > 80)
  {
    col = c80_100;
    numSeg = 5;
  }
  else if (myCellPercent > 60 && myCellPercent <= 80)
  {
    col = c60_80;
    numSeg = 4;
  }
  else if (myCellPercent > 40 && myCellPercent <= 60)
  {
    col = c40_60;
    numSeg = 3;
  }
  else if (myCellPercent > 20 && myCellPercent <= 40)
  {
    col = c20_40;
    numSeg = 2;
  }
  else
  {
    col = c00_20;
    numSeg = 1;
  }

  // Shape of the battery
  myUI.tft().fillSmoothRoundRect(cPosX+46, cPosY+7, 5, 12, 2, cBorderCol, TFT_BLACK);
  myUI.tft().drawSmoothRoundRect(cPosX, cPosY, 4, 3, 46, 25, cBorderCol, TFT_BLACK);

  // No valid reading yet: outline only. Low battery: the segment blinks.
  if (myCellPercent < 0 || myBlinkOn == false)
    return;

  // Visualize charge percentage
  myUI.tft().fillRect(cPosX+4, cPosY+4, numSeg*8-1, 18, col);
  for (int i=1; i<numSeg; i++)
  {
    myUI.tft().drawFastVLine(cPosX+4+i*8-1, cPosY+4, 18, TFT_BLACK);
  }
}
