forgevolt/Transmitter/software/Transmitter/FPSToggle.cpp

#include "FPSToggle.h"
#include <Preferences.h>

// ---- FPSToggle -------------------------------------------------------------------------

namespace
{

const String cMenuNameOn  = "Show FPS";
const String cMenuNameOff = "Hide FPS";

constexpr const char* cPreferencesNS = "FPS";
constexpr const char* cKey           = "showFPS";

} // namespace

// ----------------------------------------------------------------------------------------
FPSToggle::FPSToggle(UserInterface& ui, Menu& menu)
: MenuItem(ui, menu, "")
{
  // Read FPS configuration from preferences
  Preferences p;
  p.begin(cPreferencesNS, true); // read-only: does not create the namespace
  myShowFPS = p.getBool(cKey, true);
  p.end();

  myMenuName = myShowFPS ? cMenuNameOff : cMenuNameOn;
}

// ----------------------------------------------------------------------------------------
void FPSToggle::draw(bool forceRedraw)
{
  MenuItem::draw(needsRedraw() || forceRedraw);
  clearRedrawFlags();
}

// ----------------------------------------------------------------------------------------
void FPSToggle::start()
{
  myShowFPS = !myShowFPS;

  // Set FPS configuration
  Preferences p;
  p.begin(cPreferencesNS);
  p.putBool(cKey, myShowFPS);
  p.end();

  myMenuName = myShowFPS ? cMenuNameOff : cMenuNameOn;
  markRedraw();
}
