forgevolt/Transmitter/software/Transmitter/build_opt.h

-Wall
-Wextra
-Wdouble-promotion
-Wsign-compare
-DUSER_SETUP_LOADED
-DDISABLE_ALL_LIBRARY_WARNINGS
-DUSER_SETUP_ID=27
-DST7796_DRIVER
-DTFT_MISO=-1
-DTFT_MOSI=23
-DTFT_SCLK=18
-DTFT_CS=5
-DTFT_DC=15
-DTFT_RST=4
-DTFT_BL=2
-DTFT_BACKLIGHT_ON=HIGH
-DLOAD_GLCD
-DLOAD_FONT2
-DLOAD_FONT4
-DLOAD_FONT6
-DLOAD_FONT7
-DLOAD_FONT8
-DSMOOTH_FONT
-DSPI_FREQUENCY=80000000
