forgevolt/Transmitter/(commit log)

2026-10-09 Enable full compiler warnings and document the board settings
2026-10-10 Calibrate the IMU without blocking the loop, and check the result
2026-10-10 Send a level tilt when no IMU answered at startup
2026-10-10 Battery icon: no stale or bogus values, low-battery warning
2026-10-10 Device Type Configuration: restart only when the setting changed
2026-10-10 IMU calibration: confirm a stored result on screen
2026-10-10 Temperature: show the unit
2026-10-10 Pin and repository documentation
2026-10-11 Show joystick axes rejected by the calibration on screen
2026-10-11 no separate wiring diagram
2026-10-11 Average 4 ADC readings per joystick axis, dead zone 50
2026-10-11 Always set the SPI, I2C pins explicitly
2026-10-12 Use the JoystickUtilities library for the joysticks
    Joystick3Axis is replaced by joystickutilities::Joystick<3>, and the
    calibration screen measures with CenterSampler and RangeTracker.
2026-10-12 Show the release steps of the joystick calibration graphically
